Stylt1/8-bit-computer/schematic/KiCad/wiring.kicad_sch

## KiCad design schematic/KiCad/wiring.kicad_sch (2026-09-04)

Schematic: wiring.kicad_sch

Parts:
C1: 1uF
C2, C4, C6, C7: 10nF
C3, C5, C8, C9, C10, C11, C12, C13, C14, C15, C16, C17, C18, C19, C20, C21, C22, C23, C24, C25, C26, C27, C28, C29, C30, C31, C32, C33, C34, C35, C36, C37, C38, C39, C40, C41, C42, C43, C44, C45, C46, C47, C48: 100nF
D2: CLK
R1, R19: 1K
R2, R3, R4, R5, R6, R8, R9, R10, R20: 10K
R7: 220R
R11, R12, R13, R14, R15, R16, R17, R18: 330R
RV1: 1M
SW1: Manual/Auto
SW2: Pulse
SW3: SW_DIP_x04
U1, U41: 74LS08
U2: 74LS32
U3, U4, U5, U29: NE555P; DIP-8_W7.62mm
U6, U8, U10, U11, U20, U43, U44, U45: 74LS173
U7, U25, U26, U39: 74LS04
U9, U16, U18, U19, U42: 74LS245
U12, U13: 74LS86
U14, U15: 74LS283
U17, U36: 74LS161
U21: 74LS273
U22: 74LS157
U23, U24: 74LS189
U27, U40: 74LS00
U28, U37, U38: 28C16
U30: 74LS76
U31: 74LS139
U32, U33, U34, U35: SBC18-11EGWA; SBC18-11SURKCGKWA

Connections:
1Y_LS8: U1.3 (1Y), U2.1 (1A)
2Y_LS8: U1.6 (2Y), U2.2 (1B)
3B_LS8: U1.9 (3B), U2.3 (1Y)
+5V: C8.1, C9.1, C10.1, C11.1, C12.1, C13.1, C14.1, C15.1, C16.1, C17.1, C18.1, C19.1, C20.1, C21.1, C22.1, C23.1, C24.1, C25.1, C26.1, C27.1, C28.1, C29.1, C30.1, C31.1, C32.1, C33.1, C34.1, C35.1, C36.1, C37.1, C38.1, C39.1, C40.1, C41.1, C42.1, C43.1, C44.1, C45.1, C46.1, C47.1, C48.1, R1.2, R3.2, R4.2, R6.2, R19.1, SW3.1, SW3.2, SW3.3, SW3.4, U1.14 (VCC), U2.14 (VCC), U3.4 (~RST), U3.8 (VCC), U4.8 (VCC), U5.4 (~RST), U5.8 (VCC), U6.16 (VCC), U7.14 (VCC), U8.16 (VCC), U9.1 (DIR), U9.20 (VCC), U10.16 (VCC), U11.16 (VCC), U12.14 (VCC), U13.14 (VCC), U14.16 (VCC), U15.16 (VCC), U16.1 (DIR), U16.20 (VCC), U17.16 (VCC), U18.1 (DIR), U18.20 (VCC), U19.1 (DIR), U19.20 (VCC), U20.16 (VCC), U21.1 (MR), U21.20 (VCC), U22.16 (VCC), U23.16 (VCC), U24.16 (VCC), U25.14 (VCC), U26.14 (VCC), U27.14 (VCC), U28.21 (~WE), U28.24 (VCC), U29.4 (~RST), U29.8 (VCC), U30.2 (~PRE1), U30.3 (~CLR1), U30.4 (J1), U30.5 (VCC), U30.7 (~PRE2), U30.8 (~CLR2), U30.9 (J2), U30.12 (K2), U30.16 (K1), U31.16 (VCC), U36.7 (ENP), U36.9 (~LOAD), U36.10 (ENT), U36.16 (VCC), U37.21 (~WE), U37.24 (VCC), U38.21 (~WE), U38.24 (VCC), U39.14 (VCC), U40.14 (VCC), U41.14 (VCC), U42.1 (DIR), U42.20 (VCC), U43.16 (VCC), U44.16 (VCC), U45.16 (VCC)
A0: U38.17 (D7)
A1: U6.3 (1Q), U9.2 (A1), U14.5 (A1), U42.2 (A1), U43.3 (1Q)
A2: U6.4 (2Q), U9.3 (A2), U14.3 (A2), U42.3 (A2), U43.4 (2Q)
A3: U6.5 (3Q), U9.4 (A3), U14.14 (A3), U42.4 (A3), U43.5 (3Q)
A4: U6.6 (4Q), U9.5 (A4), U14.12 (A4), U42.5 (A4), U43.6 (4Q)
A5: U8.3 (1Q), U9.6 (A5), U15.5 (A1), U37.5 (A3), U38.5 (A3), U42.6 (A5), U44.3 (1Q)
A6: U8.4 (2Q), U9.7 (A6), U15.3 (A2), U37.4 (A4), U38.4 (A4), U42.7 (A6), U44.4 (2Q)
A7: U8.5 (3Q), U9.8 (A7), U15.14 (A3), U37.3 (A5), U38.3 (A5), U42.8 (A7), U44.5 (3Q)
A8: U8.6 (4Q), U9.9 (A8), U15.12 (A4), U37.2 (A6), U38.2 (A6), U42.9 (A8), U44.6 (4Q)
AI: U38.16 (D6)
ALU_O: U16.19 (~OE)
B1: U10.3 (1Q), U12.2 (1B)
B2: U10.4 (2Q), U12.5 (2B)
B3: U10.5 (3Q), U12.9 (3B)
B4: U10.6 (4Q), U12.12 (4B)
B5: U11.3 (1Q), U13.2 (1B)
B6: U11.4 (2Q), U13.5 (2B)
B7: U11.5 (3Q), U13.9 (3B)
B8: U11.6 (4Q), U13.12 (4B)
BI: U37.11 (D2)
BUS1: U6.14 (1D), U9.18 (B1), U10.14 (1D), U16.18 (B1), U17.3 (A), U18.18 (B1), U19.18 (B1), U20.14 (1D), U21.3 (D0), U23.4 (D1), U42.18 (B1), U43.14 (1D)
BUS2: U6.13 (2D), U9.17 (B2), U10.13 (2D), U16.17 (B2), U17.4 (B), U18.17 (B2), U19.17 (B2), U20.13 (2D), U21.4 (D1), U23.6 (D2), U42.17 (B2), U43.13 (2D)
BUS3: U6.12 (3D), U9.16 (B3), U10.12 (3D), U16.16 (B3), U17.5 (C), U18.16 (B3), U19.16 (B3), U20.12 (3D), U21.7 (D2), U23.10 (D3), U42.16 (B3), U43.12 (3D)
BUS4: U6.11 (4D), U9.15 (B4), U10.11 (4D), U16.15 (B4), U17.6 (D), U18.15 (B4), U19.15 (B4), U20.11 (4D), U21.8 (D3), U23.12 (D4), U42.15 (B4), U43.11 (4D)
BUS5: U8.14 (1D), U9.14 (B5), U11.14 (1D), U16.14 (B5), U19.14 (B5), U21.13 (D4), U24.4 (D1), U42.14 (B5), U44.14 (1D)
BUS6: U8.13 (2D), U9.13 (B6), U11.13 (2D), U16.13 (B6), U19.13 (B6), U21.14 (D5), U24.6 (D2), U42.13 (B6), U44.13 (2D)
BUS7: U8.12 (3D), U9.12 (B7), U11.12 (3D), U16.12 (B7), U19.12 (B7), U21.17 (D6), U24.10 (D3), U42.12 (B7), U44.12 (3D)
BUS8: U8.11 (4D), U9.11 (B8), U11.11 (4D), U16.11 (B8), U19.11 (B8), U21.18 (D7), U24.12 (D4), U42.11 (B8), U44.11 (4D)
C0: U14.9 (C4), U15.7 (C0)
CARRY: U15.9 (C4), U45.14 (1D)
CE: U17.7 (ENP), U17.10 (ENT), U37.14 (D4)
CF: U37.1 (A7), U38.1 (A7)
CLK: R7.1, U1.8 (3Y), U6.7 (CLK), U8.7 (CLK), U10.7 (CLK), U11.7 (CLK), U17.2 (CLK), U20.7 (CLK), U27.1 (1A), U36.2 (CLK), U43.7 (CLK), U44.7 (CLK), U45.7 (CLK)
CLK1: U29.3 (OUT), U30.1 (CLK1)
CLK2: U28.23 (A8), U30.6 (CLK2), U30.15 (Q1), U31.2 (1A)
CO: U37.15 (D5)
CONQA: U36.14 (QA), U37.8 (A0), U38.8 (A0)
CONQB: U36.13 (QB), U37.7 (A1), U38.7 (A1), U40.1 (1A)
CONQC: U36.12 (QC), U37.6 (A2), U38.6 (A2), U40.2 (1B)
CONQD: U36.11 (QD)
CONQ_0: U21.2 (Q0), U28.8 (A0)
CONQ_1: U21.5 (Q1), U28.7 (A1)
CONQ_2: U21.6 (Q2), U28.6 (A2)
CONQ_3: U21.9 (Q3), U28.5 (A3)
CONQ_4: U21.12 (Q4), U28.4 (A4)
CONQ_5: U21.15 (Q5), U28.3 (A5)
CONQ_6: U21.16 (Q6), U28.2 (A6)
CONQ_7: U21.19 (Q7), U28.1 (A7)
C_RST: U17.1 (~CLR)
EO: U37.9 (D0)
FI: U37.17 (D7), U45.1 (M), U45.2 (N)
FR_RST: U45.15 (CLR)
GND: C1.2, C2.1, C3.2, C4.1, C5.2, C6.1, C7.1, C8.2, C9.2, C10.2, C11.2, C12.2, C13.2, C14.2, C15.2, C16.2, C17.2, C18.2, C19.2, C20.2, C21.2, C22.2, C23.2, C24.2, C25.2, C26.2, C27.2, C28.2, C29.2, C30.2, C31.2, C32.2, C33.2, C34.2, C35.2, C36.2, C37.2, C38.2, C39.2, C40.2, C41.2, C42.2, C43.2, C44.2, C45.2, C46.2, C47.2, C48.2, D2.1 (K), R2.2, R5.1, R8.2, R9.2, R10.2, RV1.3, SW1.2 (B), SW2.1, U1.7 (GND), U2.7 (GND), U3.1 (GND), U4.1 (GND), U5.1 (GND), U6.1 (M), U6.2 (N), U6.8 (GND), U6.15 (CLR), U7.7 (GND), U8.1 (M), U8.2 (N), U8.8 (GND), U8.15 (CLR), U9.10 (GND), U10.1 (M), U10.2 (N), U10.8 (GND), U10.15 (CLR), U11.1 (M), U11.2 (N), U11.8 (GND), U11.15 (CLR), U12.7 (GND), U13.7 (GND), U14.8 (GND), U15.8 (GND), U16.10 (GND), U17.8 (GND), U18.6 (A5), U18.7 (A6), U18.8 (A7), U18.9 (A8), U18.10 (GND), U19.10 (GND), U20.8 (GND), U21.10 (GND), U22.8 (GND), U22.15 (ENABLE), U23.2 (~CS), U23.8 (GND), U24.2 (~CS), U24.8 (GND), U25.7 (GND), U26.7 (GND), U27.7 (GND), U28.12 (GND), U28.18 (~CS), U28.19 (A10), U28.20 (~OE), U29.1 (GND), U30.13 (GND), U31.1 (~G1), U31.8 (GND), U36.3 (A), U36.4 (B), U36.5 (C), U36.6 (D), U36.8 (GND), U37.12 (GND), U37.18 (~CS), U37.19 (A10), U37.20 (~OE), U37.22 (A9), U38.12 (GND), U38.18 (~CS), U38.19 (A10), U38.20 (~OE), U38.22 (A9), U39.7 (GND), U40.7 (GND), U41.7 (GND), U42.10 (GND), U43.1 (M), U43.2 (N), U43.8 (GND), U43.15 (CLR), U44.1 (M), U44.2 (N), U44.8 (GND), U44.15 (CLR), U45.8 (GND), U45.9 (~G1), U45.10 (~G2)
HALT_IN: U7.3 (2A), U38.9 (D0)
HALT_OUT: U1.10 (3A), U7.4 (2Y)
II: U38.15 (D5)
IO: U38.14 (D4)
InCouRST: U36.1 (~CLR), U40.3 (1Y)
J: U37.16 (D6)
JKQ2: U28.22 (A9), U30.11 (Q2), U31.3 (1B)
JUMP: U17.9 (~LOAD)
MI: U38.10 (D1)
MUX1: U22.4 (Y1), U23.1 (A0), U24.1 (A0)
MUX2: U22.7 (Y2), U23.15 (A1), U24.15 (A1)
MUX3: U22.9 (Y3), U23.14 (A2), U24.14 (A2)
MUX4: U22.12 (Y4), U23.13 (A3), U24.13 (A3)
unnamed: C1.1, RV1.2, U3.2 (TRIG), U3.6 (THRES)
unnamed: C2.2, U3.5 (CONT)
unnamed: C3.1, R20.2, U29.2 (TRIG), U29.6 (THRES)
unnamed: C4.2, U4.5 (CONT)
unnamed: C5.1, U5.6 (THRES), U5.7 (DISCH)
unnamed: C6.2, U5.5 (CONT)
unnamed: C7.2, U29.5 (CONT)
unnamed: D2.2 (A), R7.2
unnamed: R1.1, RV1.1, U3.7 (DISCH)
unnamed: R3.1, SW1.3 (C), U4.2 (TRIG)
unnamed: R5.2, U4.6 (THRES)
unnamed: R6.1, SW2.2, U5.2 (TRIG)
unnamed: R11.2, U28.9 (D0)
unnamed: R12.2, U28.10 (D1)
unnamed: R13.2, U28.11 (D2)
unnamed: R14.1, U28.17 (D7)
unnamed: R15.1, U28.16 (D6)
unnamed: R16.1, U28.15 (D5)
unnamed: R17.1, U28.14 (D4)
unnamed: R18.1, U28.13 (D3)
unnamed: R19.2, R20.1, U29.7 (DISCH)
unnamed: U17.11 (QD), U18.5 (A4)
unnamed: U17.12 (QC), U18.4 (A3)
unnamed: U17.13 (QB), U18.3 (A2)
unnamed: U17.14 (QA), U18.2 (A1)
unnamed: U20.9 (~G1), U20.10 (~G2)
OI: U21.11 (CP), U37.13 (D3)
OUT_AS: U1.1 (1A), U3.3 (OUT)
OUT_MONO: U1.4 (2A), U5.3 (OUT)
PROG1: R2.1, SW3.8, U22.3 (B1)
PROG2: R8.1, SW3.7, U22.6 (B2)
PROG3: R9.1, SW3.6, U22.10 (B3)
PROG4: R10.1, SW3.5, U22.13 (B4)
PROG/RUN: U22.1 (SELECT)
RAM_RST: U20.15 (CLR)
RI: U27.2 (1B), U38.11 (D2)
RO: U19.19 (~OE), U38.13 (D3)
RQ1: U20.3 (1Q), U22.2 (A1)
RQ2: U20.4 (2Q), U22.5 (A2)
RQ3: U20.5 (3Q), U22.11 (A3)
RQ4: U20.6 (4Q), U22.14 (A4)
RST: R4.1, SW1.1 (A), U4.4 (~RST)
SEG1: R11.1, U32.7 (A), U33.7 (A), U34.7 (A), U35.7 (A)
SEG2: R12.1, U32.6 (B), U33.6 (B), U34.6 (B), U35.6 (B)
SEG3: R13.1, U32.4 (C), U33.4 (C), U34.4 (C), U35.4 (C)
SEG4: R18.2, U32.3 (D), U33.3 (D), U34.3 (D), U35.3 (D)
SEG5: R17.2, U32.2 (E), U33.2 (E), U34.2 (E), U35.2 (E)
SEG6: R16.2, U32.9 (F), U33.9 (F), U34.9 (F), U35.9 (F)
SEG7: R15.2, U32.10 (G), U33.10 (G), U34.10 (G), U35.10 (G)
SEG8: R14.2, U32.8 (DP), U33.8 (DP), U34.8 (DP), U35.8 (DP)
SEGCC1: U31.4 (1Y0), U32.5 (CC)
SEGCC2: U31.5 (1Y1), U33.5 (CC)
SEGCC3: U31.6 (1Y2), U34.5 (CC)
SEGCC4: U31.7 (1Y3), U35.5 (CC)
SELECT_IN: U1.2 (1B), U4.3 (OUT), U7.1 (1A)
SELECT_OUT: U1.5 (2B), U7.2 (1Y)
SQ1: U19.2 (A1), U25.2 (1Y)
SQ2: U19.3 (A2), U25.4 (2Y)
SQ3: U19.4 (A3), U25.6 (3Y)
SQ4: U19.5 (A4), U25.8 (4Y)
SQ5: U19.6 (A5), U26.2 (1Y)
SQ6: U19.7 (A6), U26.4 (2Y)
SQ7: U19.8 (A7), U26.6 (3Y)
SQ8: U19.9 (A8), U26.8 (4Y)
SU: U37.10 (D1)
SUB: U12.1 (1A), U12.4 (2A), U12.10 (3A), U12.13 (4A), U13.1 (1A), U13.4 (2A), U13.10 (3A), U13.13 (4A), U14.7 (C0)
SUM1: U14.4 (S1), U16.2 (A1)
SUM2: U14.1 (S2), U16.3 (A2)
SUM3: U14.13 (S3), U16.4 (A3)
SUM4: U14.10 (S4), U16.5 (A4)
SUM5: U15.4 (S1), U16.6 (A5)
SUM6: U15.1 (S2), U16.7 (A6)
SUM7: U15.13 (S3), U16.8 (A7)
SUM8: U15.10 (S4), U16.9 (A8)
WE: U23.3 (~WE), U24.3 (~WE), U27.3 (1Y)
XB1: U12.3 (1Y), U14.6 (B1)
XB2: U12.6 (2Y), U14.2 (B2)
XB3: U12.8 (3Y), U14.15 (B3)
XB4: U12.11 (4Y), U14.11 (B4)
XB5: U13.3 (1Y), U15.6 (B1)
XB6: U13.6 (2Y), U15.2 (B2)
XB7: U13.8 (3Y), U15.15 (B3)
XB8: U13.11 (4Y), U15.11 (B4)
ZF: U37.23 (A8), U38.23 (A8), U45.13 (2D)
~AI: U6.9 (~G1), U6.10 (~G2), U8.9 (~G1), U8.10 (~G2)
~AO: U9.19 (~OE)
~BI: U10.9 (~G1), U10.10 (~G2), U11.9 (~G1), U11.10 (~G2)
~C0: U18.19 (~OE)
~II: U43.9 (~G1), U43.10 (~G2), U44.9 (~G1), U44.10 (~G2)
~IO: U42.19 (~OE)
~MAR_I: U20.1 (M), U20.2 (N)
~SQ1: U23.5 (~Q1), U25.1 (1A)
~SQ2: U23.7 (~Q2), U25.3 (2A)
~SQ3: U23.9 (~Q3), U25.5 (3A)
~SQ4: U23.11 (~Q4), U25.9 (4A)
~SQ5: U24.5 (~Q1), U26.1 (1A)
~SQ6: U24.7 (~Q2), U26.3 (2A)
~SQ7: U24.9 (~Q3), U26.5 (3A)
~SQ8: U24.11 (~Q4), U26.9 (4A)

Notes on the sheet:
Register
Registers and ALU
PULSE
16x8 SRAM Storage
CLOCK MODULE
Monostable
Astable
Output Inverters
Counter & Bus Output
RAM Bus Transceiver
ALU
Transciever
MAR
Adder
MODE
Instruction Register
Address MUX & Manual Control
Write Pulse Logic
Substraction Logic
Bistable
RAM & program counter
